jendo42/P162101/docs/schematic_r1.1.pdf

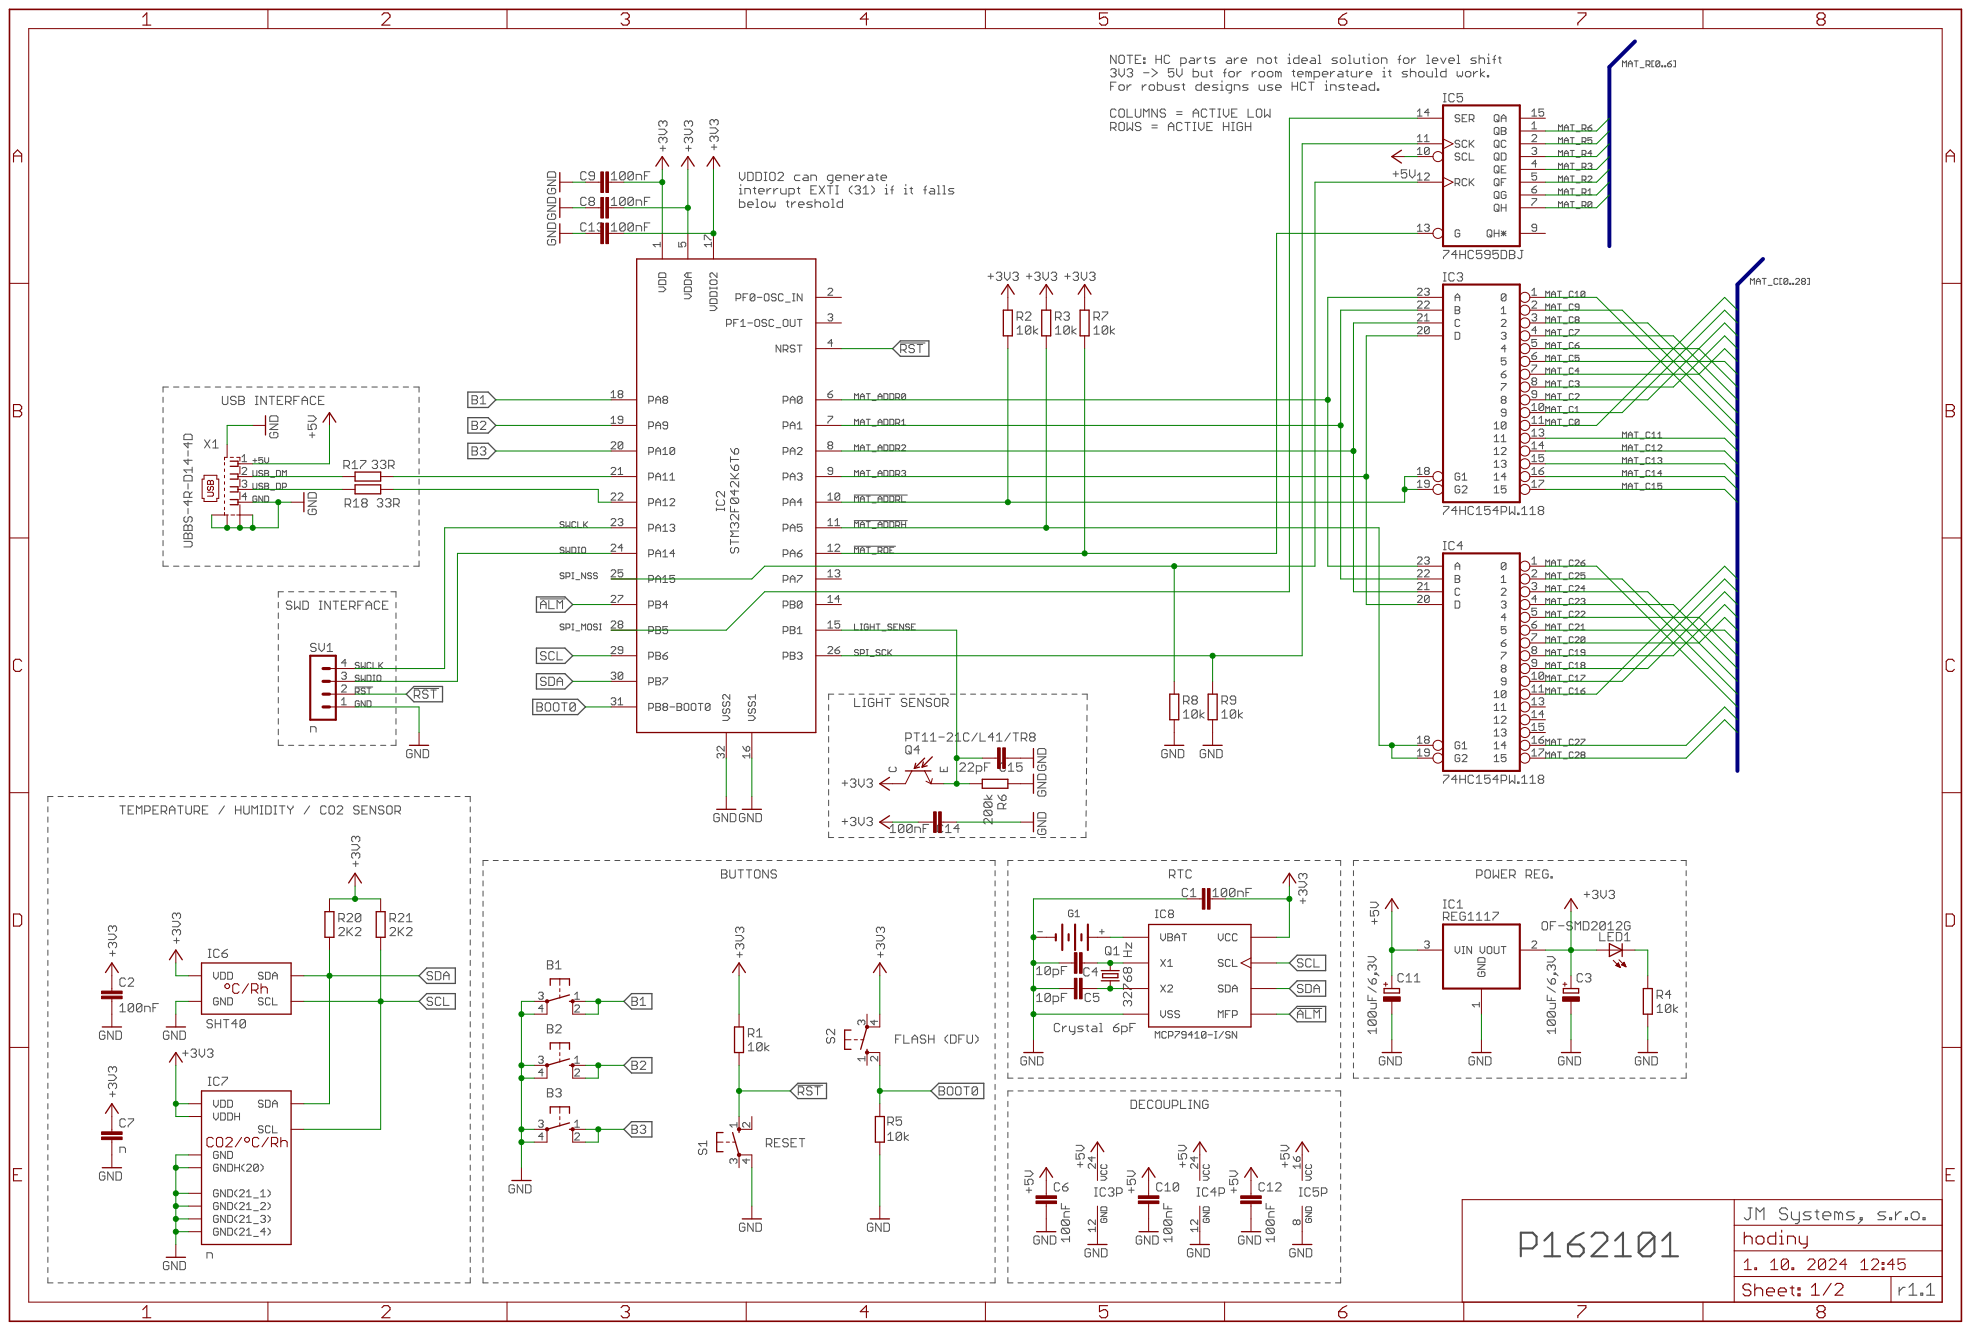
[picture p6: page 1]

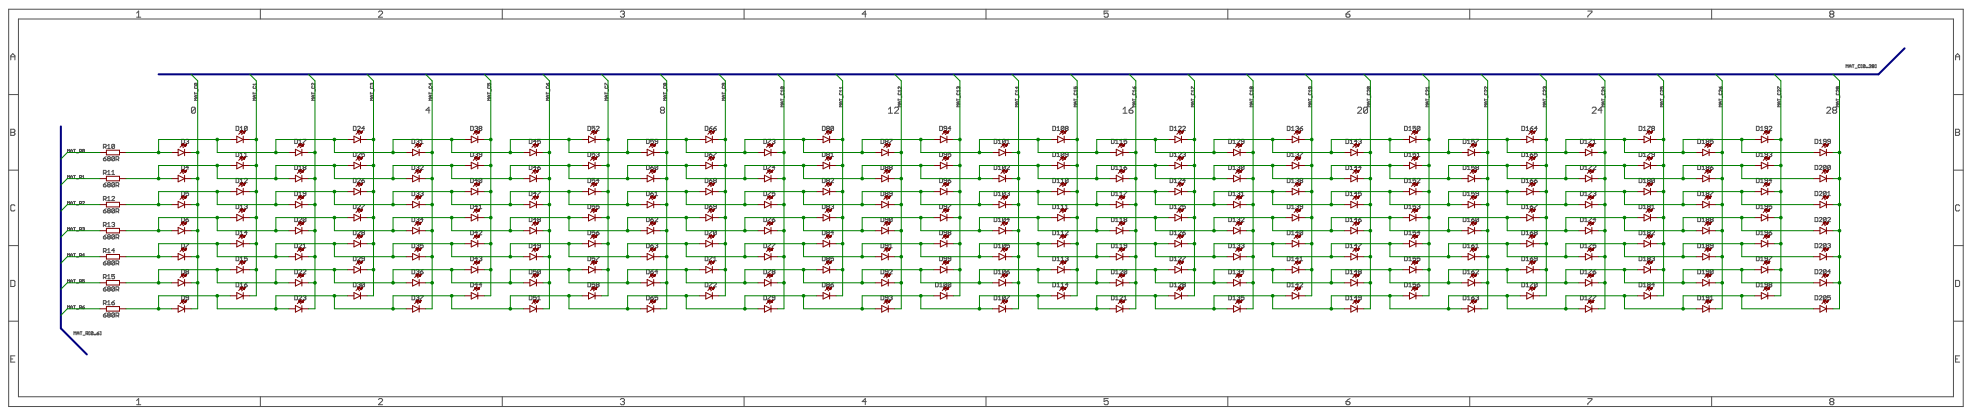
[picture p7: page 2]
