jendo42/P162101/docs/top_frame_r1.1.pdf

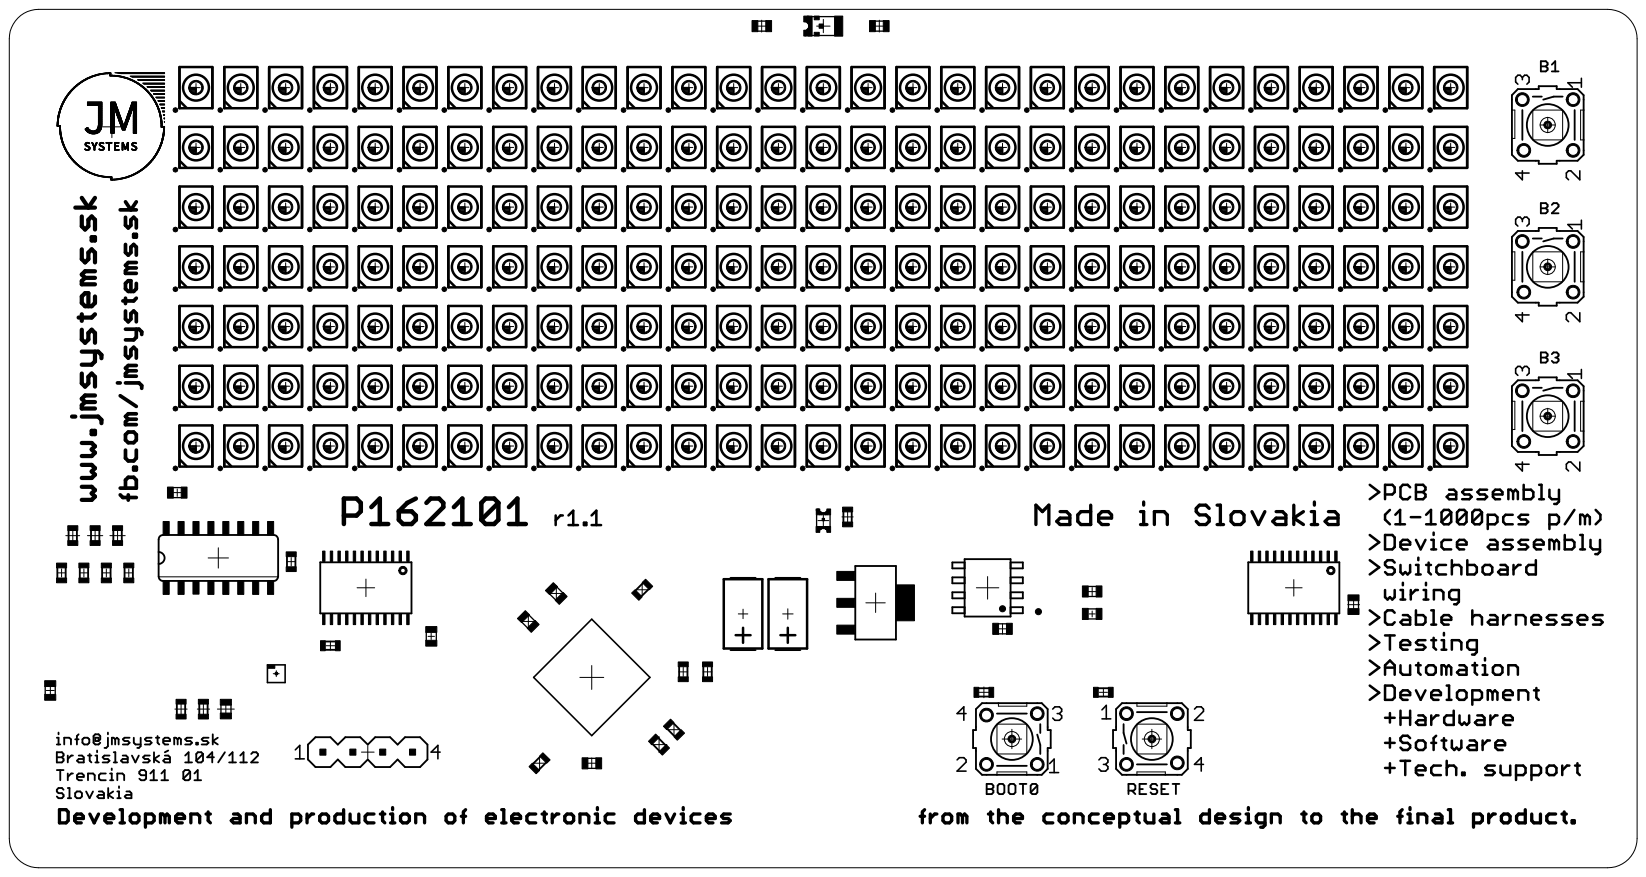
[picture p8: page 1]
