jendo42/P162101/(commit log)

2023-12-22 addded I2C peripherals + clock rolling animation
    - SHT40 for temperature and humidity
    - better processing of buttons
    - displaying errors if I2C peripheral is not responding
    [P162101.ino]
2024-07-15 Introduced new HW r1.1, added temperature and humidity measurement
2024-10-01 Updated to lastest full featured version
    - using timer interrupt to drive screen
    - 7 available screens
    - more stable sync and rendering
    - slight more clean code (:
2024-10-02 fixed overflow of date
    [P162101.ino, utility.cpp, utility.h]
2024-10-09 calculating display brightness inside interrupt
2024-10-09 load RTC trim default only when battery died
2024-10-09 start test mode on light sensor data screen
2024-10-09 nibble2hex fixed printing characters
    [utility.cpp]
2024-10-09 factory automatic test mode, test all buttons first
2024-10-09 introduced button release notification
2024-10-09 introduced "light receiver" using on-board phototransistor
    - for bulk and remote time setting
    - simple transmission using low-speed direct UART-connected LED
    - data packets are 6b/8b encoded to allow sync by transitions
    - 300 baud rate mode
    - using MMA filter for background noise and DC offset elimination
    - CRC8 for data validation
    [P162101.ino, light_receiver.cpp, utility.cpp, utility.h]
2024-12-10 cleanup button handling in TEST mode
2025-10-19 Speed-up I2C clock to remove animation glitches
    [P162101.ino]
2025-10-19 Fixed handling dst_factory_force
    - caused to force DST state ON and did not sync properly to EEPROM
    [P162101.ino]
2025-10-20 Simplified & fixed calculating DST period
    [utility.cpp]
2025-10-20 Remove unused library: SPI.h
2025-10-20 Revert "Show message when DST state forcefully changes in test mode"
    This reverts commit 4d1a8359eba8156cf2e9a8b5d79a170d74c72696.
    [P162101.ino]
